mateussantos21/PID_FollowLineRobot/IMG_20180716_095800592.jpg

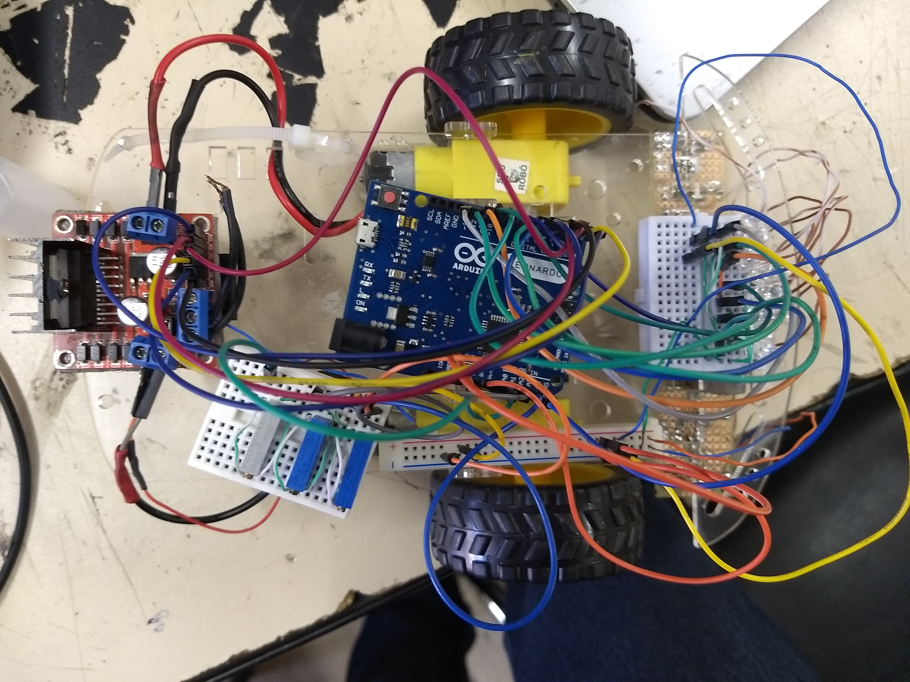
IMG_20180716_095800592.jpg
