mateussantos21/PID_FollowLineRobot/(list of files, drawings)

Other design files:
microcontrollerlessFollowLine.pdsprj
